B1narySolutions/seed3-carrier-board/README.md

# seed3-carrier

KiCad carrier board for the Daisy Seed, part of a capstone project: a portable touchscreen practice guitar amp.
The firmware is in [realtime-nam-seed3](https://github.com/B1narySolutions/realtime-nam-seed3).

## Layout

- `rev1/`: the board sent to fabrication on 2026-09-15 (also tagged `rev1`). Keep it unchanged while it is being tested. Manufacturing files are in `rev1/fabrication/`.
- `rev2/`: the next revision. The schematic starts as a copy of rev 1. There is no PCB file yet: rev 2 gets a full re-layout on a 4-layer stackup, starting from a new board in KiCad. Changes from rev 1 are listed in [`rev2/CHANGES.md`](rev2/CHANGES.md).
- `Seed3_Carrier.pretty/` and `seed3-carrier.kicad_sym`: footprint and symbol libraries shared by both revisions.
- `3dmodels/`: simplified STEP placeholder models for parts without a vendor 3D model (pots, jacks, Daisy Seed), generated by `make_placeholders.py`.
- `mechanical/`: STEP export of the rev 1 board assembly, for enclosure design.
- `TEST_PLAN.md`: post-assembly bring-up and acceptance tests for rev 1.
- [`studies/`](studies/): analysis of the board's behaviour (scripts, figures, write-ups). Current studies cover rev 1.

Open `rev1/seed3-carrier.kicad_pro` or `rev2/seed3-carrier.kicad_pro` in KiCad 10.

## Project documentation

Documentation lives alongside the work: hardware docs (board measurements, test plans, the rev 2 change list) in
this repository, firmware docs in [realtime-nam-seed3](https://github.com/B1narySolutions/realtime-nam-seed3).
