B1narySolutions/seed3-carrier-board/3dmodels/Neutrik_NRJ4HF_placeholder.step

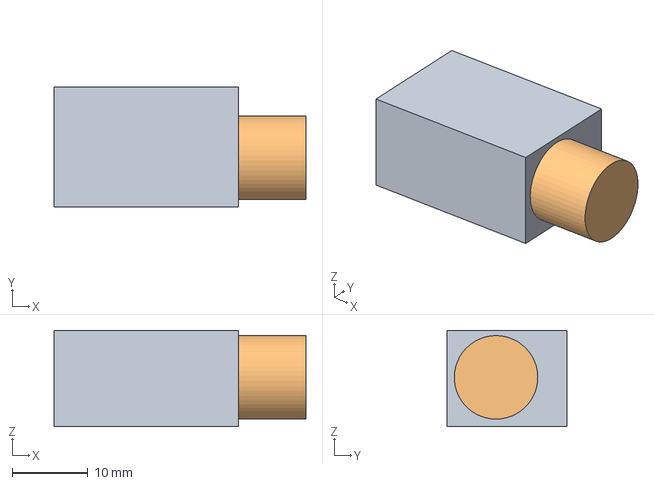
[picture p1: CAD file, 2026-10-18]
3dmodels/Neutrik_NRJ4HF_placeholder.step
33.2 x 15.8 x 12.7 mm
