B1narySolutions/seed3-carrier-board/mechanical/seed3-carrier.step

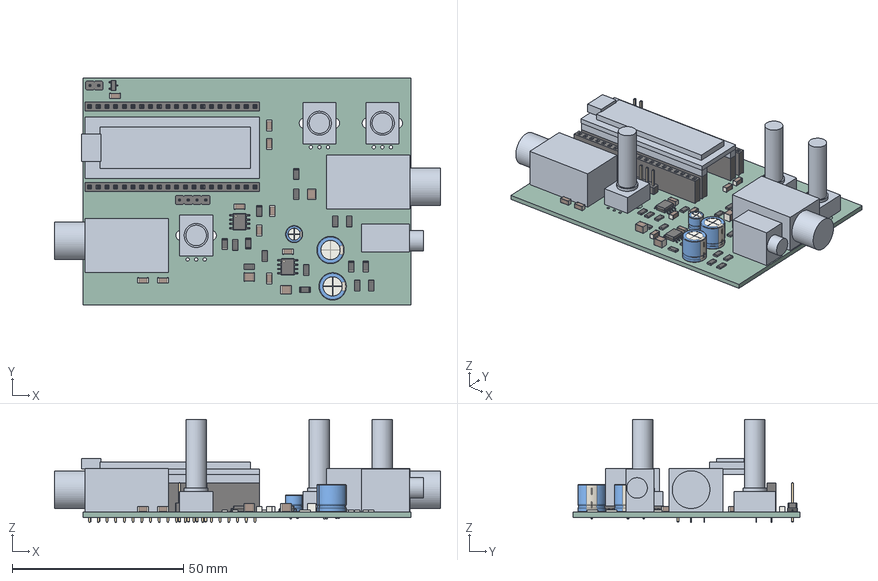
[picture p2: CAD file, 2026-10-18]
mechanical/seed3-carrier.step
112.7 x 66.2 x 30.1 mm
R_1206_3216Metric x 16
C_1206_3216Metric x 10
SOIC-8_3.9x4.9mm_P1.27mm x 2
PinSocket_1x20_P2.54mm_Vertical x 4
C_1210_3225Metric x 3
CP_Radial_D80mm_P350mm x 2
SOT-23
CP_Radial_D50mm_P200mm
PinHeader_1x02_P254mm_Vertical
PinHeader_1x04_P254mm_Vertical
seed3-carrier_PCB
