B1narySolutions/seed3-carrier-board/3dmodels/Bourns_PTV09A-4020F_placeholder.step

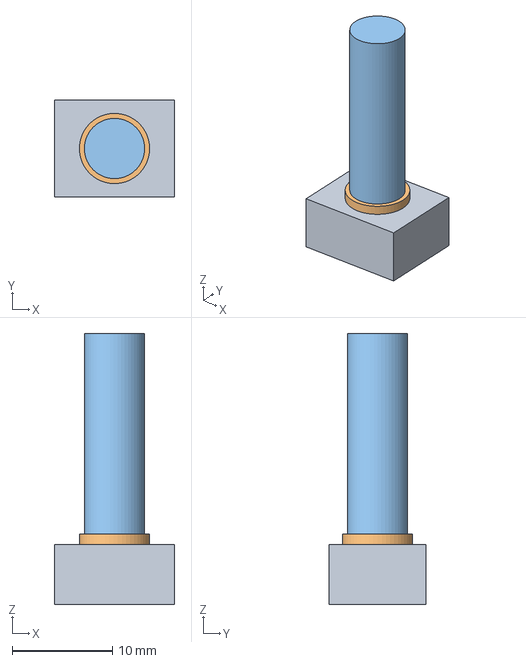
[picture p3: CAD file, 2026-10-18]
3dmodels/Bourns_PTV09A-4020F_placeholder.step
12.0 x 9.70 x 27.0 mm
