B1narySolutions/seed3-carrier-board/3dmodels/Electrosmith_Daisy_Seed_placeholder.step

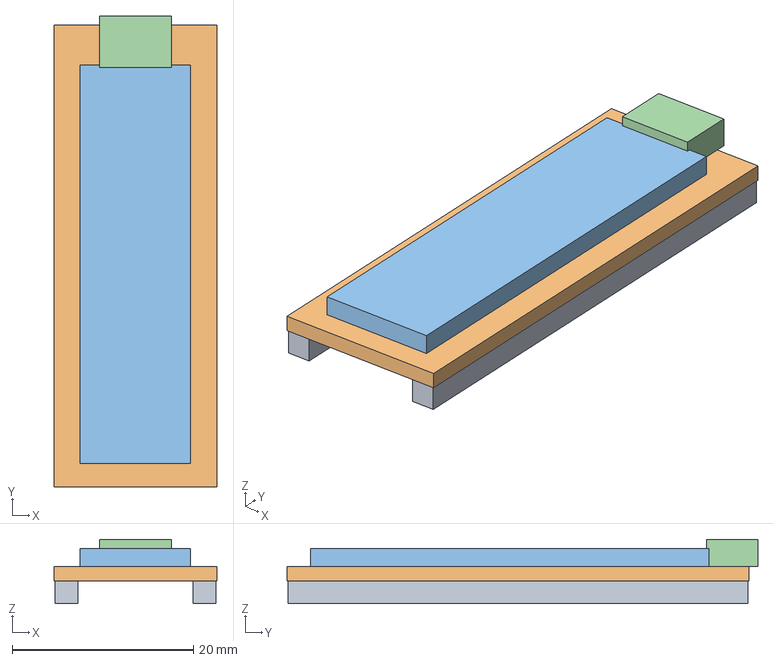
[picture p4: CAD file, 2026-10-18]
3dmodels/Electrosmith_Daisy_Seed_placeholder.step
18.0 x 52.0 x 7.10 mm
