B1narySolutions/seed3-carrier-board/3dmodels/SameSky_SJ1-3535NG_placeholder.step

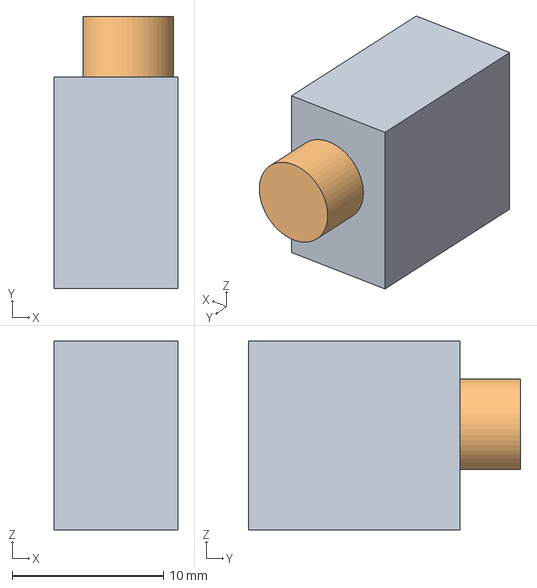
[picture p5: CAD file, 2026-10-18]
3dmodels/SameSky_SJ1-3535NG_placeholder.step
8.20 x 18.0 x 12.5 mm
