B1narySolutions/seed3-carrier-board/fabrication/README.txt

Use 2026-09-15-e7ddc60/seed3-carrier-e7ddc60-JLCPCB.zip for manufacturing.
Superseded manufacturing packages have been removed; they remain available in Git history. See the current package README for mounting and verification notes.
The BOM is seed3-carrier-BOM.csv; no placement files are included.
The BOM now contains selected manufacturer part numbers, small-quantity DigiKey ordering numbers, product links, and quantities per board. Purchase Quantity excludes the already-owned Daisy module and bare PCB test pads.
Purchasing fields were added to the CSV on 2026-09-15; they are not all stored in the schematic. Preserve these fields when regenerating the BOM from KiCad.
The BOM was regenerated from seed3-carrier.kicad_sch with kicad-cli 10.0.5 on 2026-09-17; references, values, footprints and quantities matched the existing CSV exactly, so no part selections changed.
DigiKey stock, part status and qty-1 unit price were rechecked on 2026-09-17 and recorded in the Part Status, DigiKey Stock, Unit Price (qty 1) and Stock Checked columns. All 28 ordering numbers were in stock. C9 (GMK316BJ106KL-T) and C12/C13 (GRM32ER71H475KA88L) remain Not For New Designs with ample stock. Availability can be cached; recheck at checkout.
