B1narySolutions/seed3-carrier-board/rev1/fabrication/2026-09-15-e7ddc60/README.txt

Current manufacturing package from committed design e7ddc60.
Includes resized board, routing corrections, and latest R3/R4 placement.
Board outline: 95.758 x 66.167 mm; 2 copper layers; configured thickness 1.6 mm.
Exported from a zone-refilled copy of the committed PCB, with absolute origins.
DRC: zero errors, zero unconnected items, zero schematic parity issues.
Eight existing connector/module silkscreen-edge warnings remain.
ZIP: seven Gerber layers, PTH and NPTH Excellon drills, Gerber job metadata.
Potentiometer mounting tabs use six 3.0 mm plated holes; solder these tabs.
BOM remains ../seed3-carrier-BOM.csv; no BOM or placement file inside ZIP.
This package supersedes all earlier manufacturing packages in fabrication/.
