B1narySolutions/seed3-carrier-board/rev1/seed3-carrier.kicad_pcb

## KiCad design rev1/seed3-carrier.kicad_pcb (2026-10-18, an earlier design)

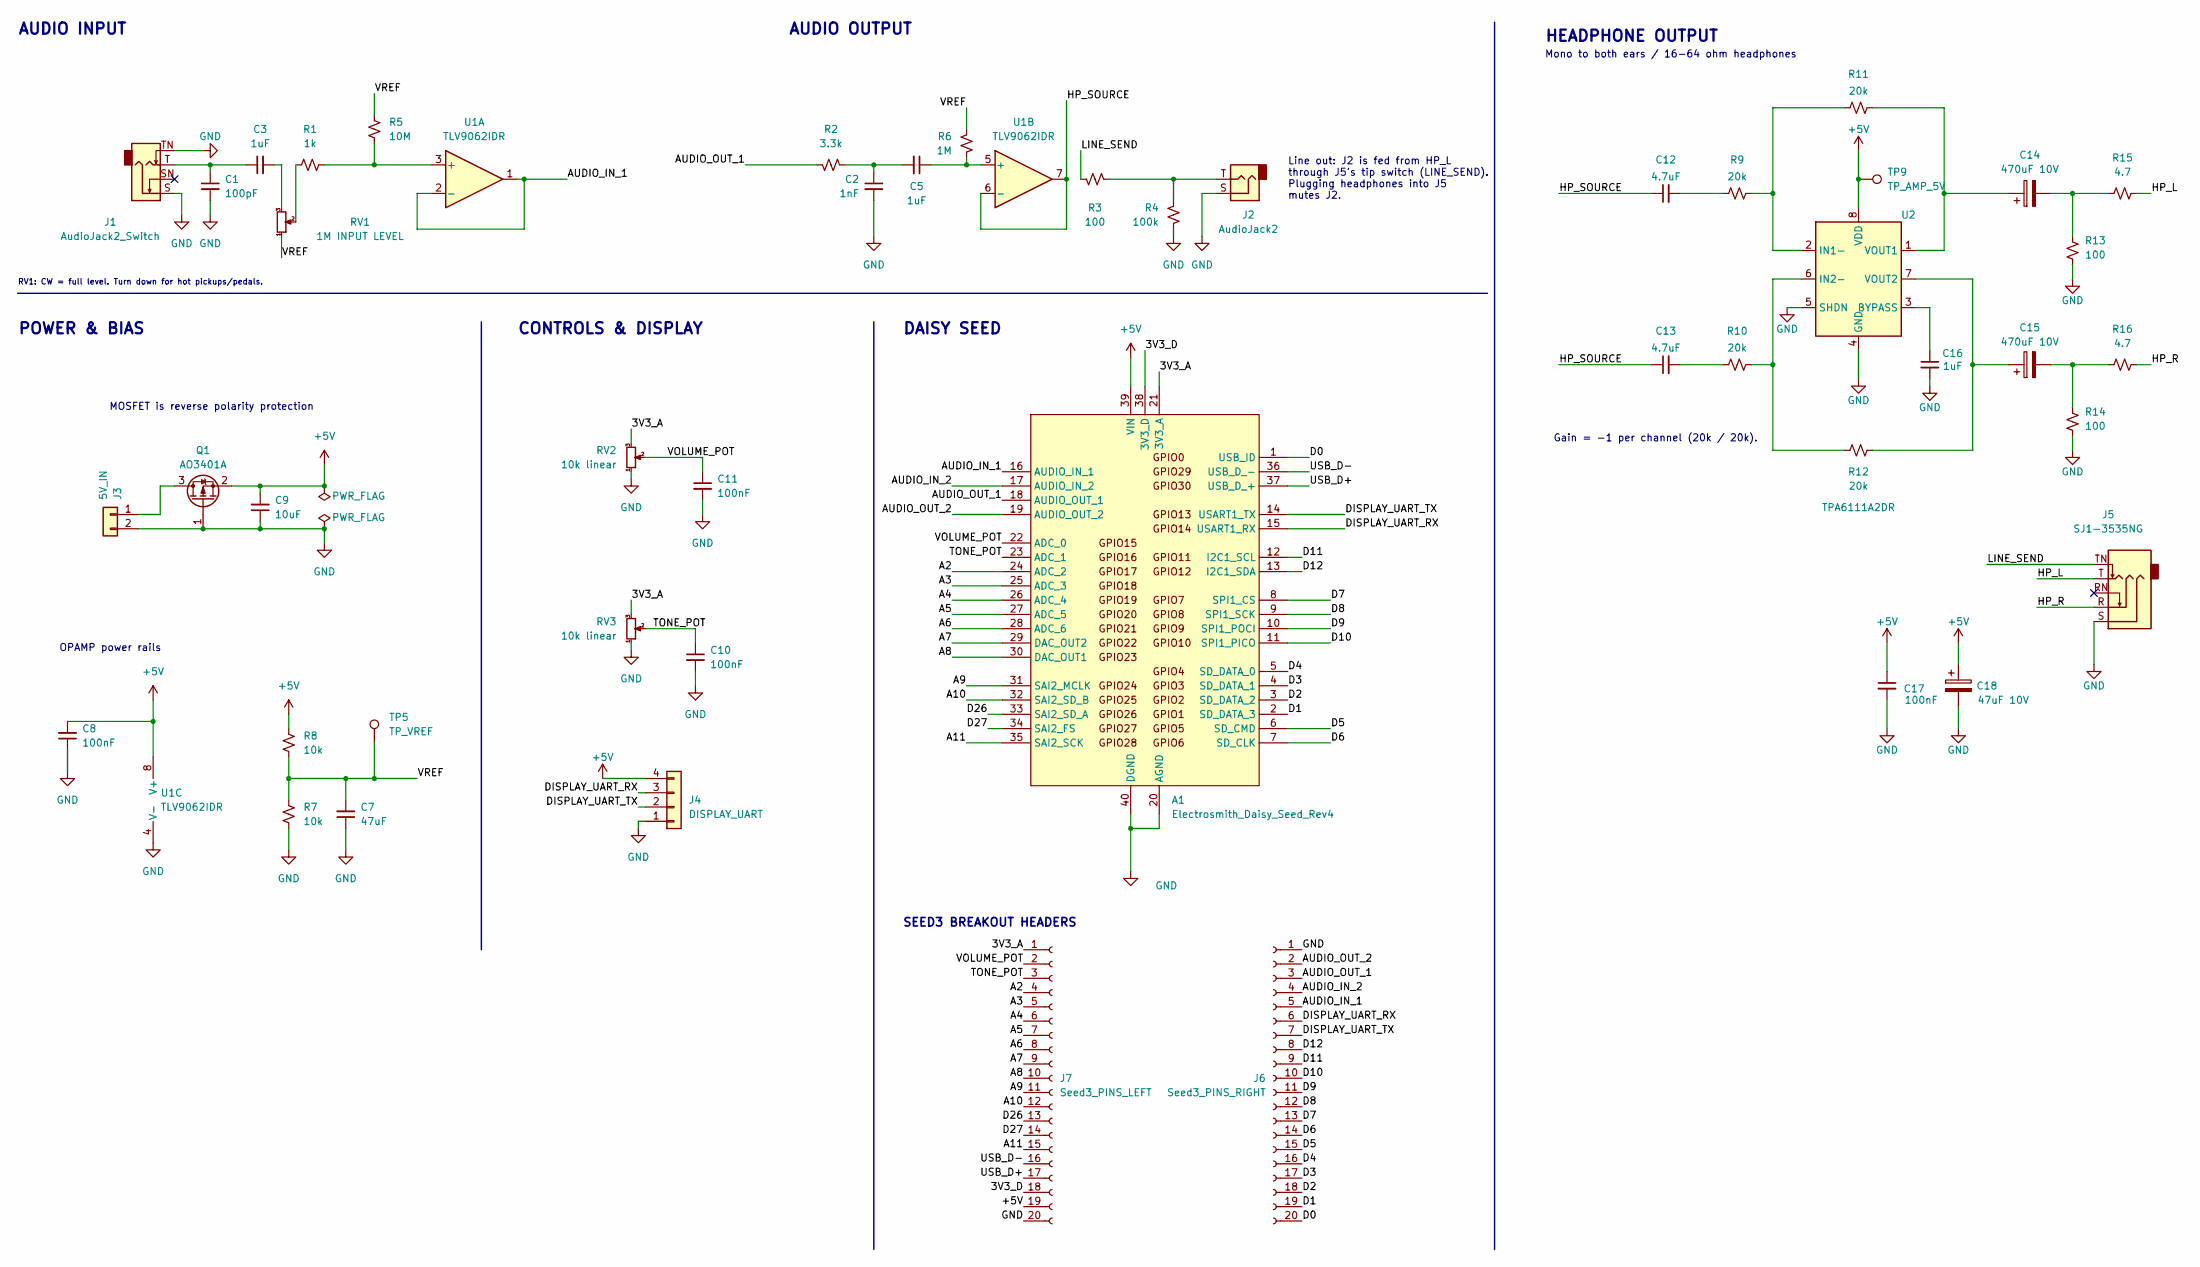
[picture p6: schematic seed3-carrier.kicad_sch, Seed3 Carrier]

Parts:
A1: Electrosmith_Daisy_Seed_Rev4; Electrosmith_Daisy_Seed
C1: 100pF; C_1206_3216Metric_Pad1.33x1.80mm_HandSolder
C2: 1nF; C_1206_3216Metric_Pad1.33x1.80mm_HandSolder
C3, C5, C16: 1uF; C_1206_3216Metric_Pad1.33x1.80mm_HandSolder
C7: 47uF; C_1210_3225Metric_Pad1.33x2.70mm_HandSolder
C8, C10, C11, C17: 100nF; C_1206_3216Metric_Pad1.33x1.80mm_HandSolder
C9: 10uF; C_1206_3216Metric_Pad1.33x1.80mm_HandSolder
C12, C13: 4.7uF; C_1210_3225Metric_Pad1.33x2.70mm_HandSolder; MPN GRM32ER71H475KA88L
C14, C15: 470uF 10V; CP_Radial_D8.0mm_P3.50mm
C18: 47uF 10V; CP_Radial_D5.0mm_P2.00mm
J1: AudioJack2_Switch; Jack_6.35mm_Neutrik_NRJ4HF_Horizontal
J2: AudioJack2; Jack_6.35mm_Neutrik_NRJ4HF_Horizontal
J3: 5V_IN; PinHeader_1x02_P2.54mm_Vertical
J4: DISPLAY_UART; PinHeader_1x04_P2.54mm_Vertical
J5: SJ1-3535NG; Jack_3.5mm_CUI_SJ1-3535NG_Horizontal
J6: Seed3_PINS_RIGHT; PinSocket_1x20_P2.54mm_Vertical
J7: Seed3_PINS_LEFT; PinSocket_1x20_P2.54mm_Vertical
Q1: AO3401A; SOT-23
R1: 1k; R_1206_3216Metric_Pad1.30x1.75mm_HandSolder
R2: 3.3k; R_1206_3216Metric_Pad1.30x1.75mm_HandSolder
R3, R13, R14: 100; R_1206_3216Metric_Pad1.30x1.75mm_HandSolder
R4: 100k; R_1206_3216Metric_Pad1.30x1.75mm_HandSolder
R5: 10M; R_1206_3216Metric_Pad1.30x1.75mm_HandSolder
R6: 1M; R_1206_3216Metric_Pad1.30x1.75mm_HandSolder
R7, R8: 10k; R_1206_3216Metric_Pad1.30x1.75mm_HandSolder
R9, R10, R11, R12: 20k; R_1206_3216Metric_Pad1.30x1.75mm_HandSolder
R15, R16: 4.7; R_1206_3216Metric_Pad1.30x1.75mm_HandSolder
RV1: 1M INPUT LEVEL; Potentiometer_Bourns_PTV09A-4_Single_Vertical_3mmMount; MPN PTV09A-4020F-B105
RV2, RV3: 10k linear; Potentiometer_Bourns_PTV09A-4_Single_Vertical_3mmMount; MPN PTV09A-4020F-B103
TP5: TP_VREF; TestPoint_Pad_D2.0mm
TP9: TP_AMP_5V; TestPoint_Pad_D2.0mm
U1: TLV9062IDR; SOIC-8_3.9x4.9mm_P1.27mm
U2: TPA6111A2DR; SOIC-8_3.9x4.9mm_P1.27mm

Connections:
+5V: A1.39 (VIN), C8.2, C9.2, C17.1, C18.1, J4.4, J7.19, Q1.2 (S), R8.1, TP9.1 (1_1), U1.8 (V+), U2.8 (VDD)
/3V3_A: A1.21 (3V3_A), J7.1, RV2.3, RV3.3
/3V3_D: A1.38 (3V3_D), J7.18
/A2: A1.24 (ADC_2), J7.4
/A3: A1.25 (ADC_3), J7.5
/A4: A1.26 (ADC_4), J7.6
/A5: A1.27 (ADC_5), J7.7
/A6: A1.28 (ADC_6), J7.8
/A7: A1.29 (DAC_OUT2), J7.9
/A8: A1.30 (DAC_OUT1), J7.10
/A9: A1.31 (SAI2_MCLK), J7.11
/A10: A1.32 (SAI2_SD_B), J7.12
/A11: A1.35 (SAI2_SCK), J7.15
/AUDIO_IN_1: A1.16 (AUDIO_IN_1), J6.5, U1.1, U1.2 (-)
/AUDIO_IN_2: A1.17 (AUDIO_IN_2), J6.4
/AUDIO_OUT_1: A1.18 (AUDIO_OUT_1), J6.3, R2.2
/AUDIO_OUT_2: A1.19 (AUDIO_OUT_2), J6.2
/D0: A1.1 (USB_ID), J6.20
/D1: A1.2 (SD_DATA_3), J6.19
/D2: A1.3 (SD_DATA_2), J6.18
/D3: A1.4 (SD_DATA_1), J6.17
/D4: A1.5 (SD_DATA_0), J6.16
/D5: A1.6 (SD_CMD), J6.15
/D6: A1.7 (SD_CLK), J6.14
/D7: A1.8 (SPI1_CS), J6.13
/D8: A1.9 (SPI1_SCK), J6.12
/D9: A1.10 (SPI1_POCI), J6.11
/D10: A1.11 (SPI1_PICO), J6.10
/D11: A1.12 (I2C1_SCL), J6.9
/D12: A1.13 (I2C1_SDA), J6.8
/D26: A1.33 (SAI2_SD_A), J7.13
/D27: A1.34 (SAI2_FS), J7.14
/DISPLAY_UART_RX: A1.15 (USART1_RX), J4.3, J6.6
/DISPLAY_UART_TX: A1.14 (USART1_TX), J4.2, J6.7
/HP_L: J5.T, R15.2
/HP_R: J5.R, R16.2
/HP_SOURCE: C12.1, C13.1, U1.6 (-), U1.7
/LINE_SEND: J5.TN, R3.2
/TONE_POT: A1.23 (ADC_1), C10.1, J7.3, RV3.2
/USB_D+: A1.37 (USB_D_+), J7.17
/USB_D-: A1.36 (USB_D_-), J7.16
/VOLUME_POT: A1.22 (ADC_0), C11.1, J7.2, RV2.2
/VREF: C7.2, R5.1, R6.1, R7.1, R8.2, RV1.1, TP5.1 (1_1)
GND: A1.20 (AGND), A1.40 (DGND), C1.2, C2.2, C7.1, C8.1, C9.1, C10.2, C11.2, C16.2, C17.2, C18.2, J1.S, J1.TN, J2.S, J3.2, J4.1, J5.S, J6.1, J7.20, Q1.1 (G), R4.1, R7.2, R13.2, R14.2, RV2.1, RV3.1, U1.4 (V-), U2.4 (GND), U2.5 (SHDN)
unnamed: C1.1, C3.1, J1.T
unnamed: C2.1, C5.2, R2.1
unnamed: C3.2, RV1.3
unnamed: C12.2, R9.1
unnamed: C13.2, R10.1
unnamed: C14.2, R13.1, R15.1
unnamed: C15.2, R14.1, R16.1
unnamed: J2.T, R3.1, R4.2
unnamed: J3.1, Q1.3 (D)
unnamed: R1.1, RV1.2
unnamed: R1.2, R5.2, U1.3 (+)
unnamed: C5.1, R6.2, U1.5 (+)
unnamed: C16.1, U2.3 (BYPASS)
unnamed: R9.2, R11.1, U2.2 (IN1-)
unnamed: R10.2, R12.1, U2.6 (IN2-)
unnamed: C14.1, R11.2, U2.1 (VOUT1)
unnamed: C15.1, R12.2, U2.7 (VOUT2)

Notes on the sheet:
RV1: CW = full level. Turn down for hot pickups/pedals.
HEADPHONE OUTPUT
AUDIO OUTPUT
DAISY SEED
SEED3 BREAKOUT HEADERS
OPAMP power rails
AUDIO INPUT
MOSFET is reverse polarity protection
Mono to both ears / 16-64 ohm headphones
Gain = -1 per channel (20k / 20k).
CONTROLS & DISPLAY
POWER & BIAS
Line out: J2 is fed from HP_L through J5's tip switch (LINE_SEND). Plugging headphones into J5 mutes J2.

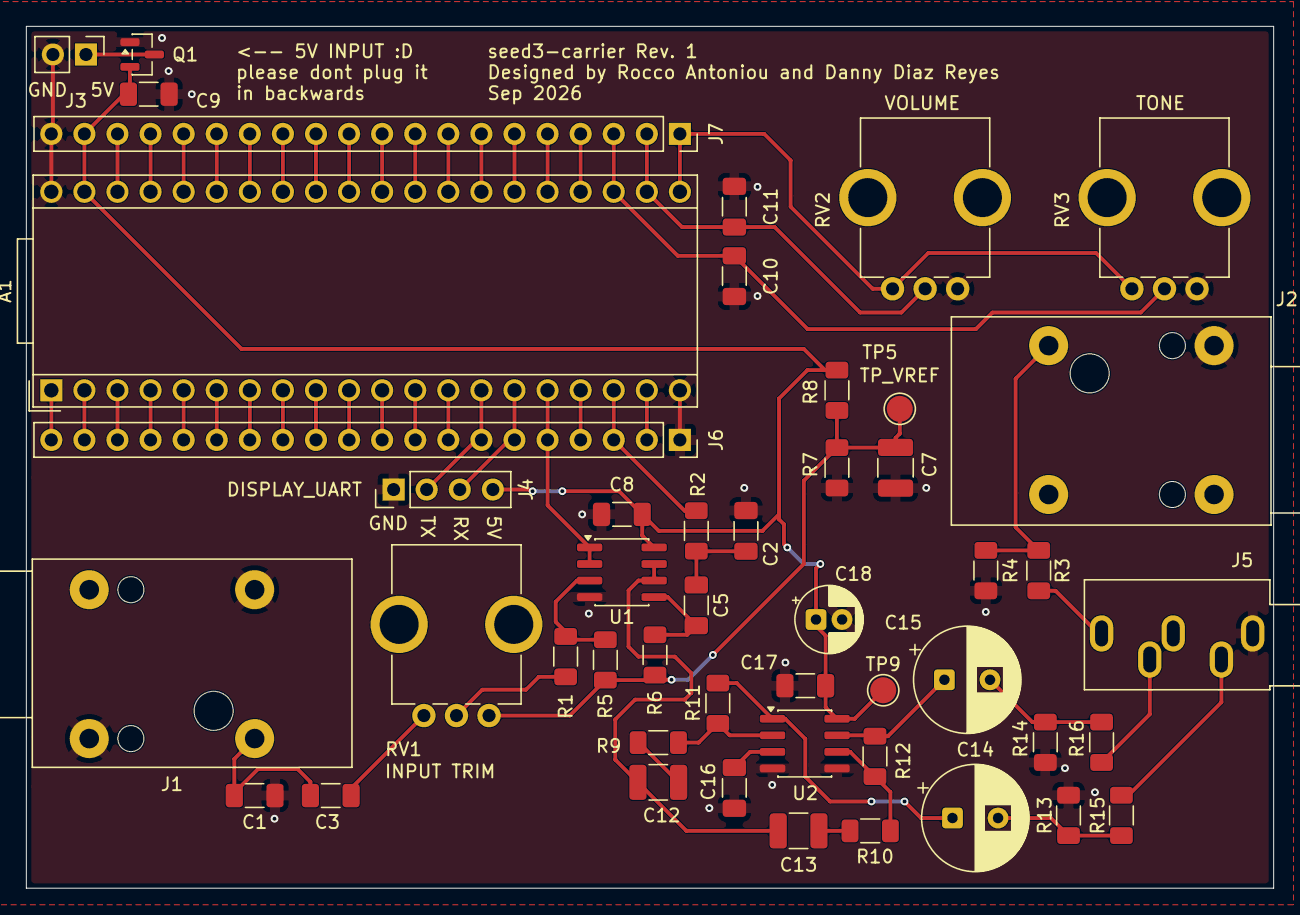
[picture p7: board seed3-carrier.kicad_pcb from above]

Board: 2 copper layers, 95.8 x 66.2 mm, 48 parts (0 on the bottom side), 61 nets.
