B1narySolutions/seed3-carrier-board/(commit log)

2026-09-17 Verify BOM against DigiKey and add ordering lists
    Regenerate the BOM from seed3-carrier.kicad_sch with kicad-cli 10.0.5.
    References, values, footprints and quantities matched the existing CSV
    exactly, so no part selections changed.
    Verify all 28 DigiKey ordering numbers against the live product pages:
    electrical value, package against the KiCad footprint, and stock. All
    28 match and all are in stock. Record part status, stock, qty-1 unit
    price and the check date in new BOM columns.
    Connector contact counts were cross-checked against the netlist: J1
    uses all four contacts of the mono NRJ4HF, J5 all five of the
    SJ1-3535NG, and every other part's pin count fits its package.
    Add DigiKey order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
    [digikey-order-1board.csv, seed3-carrier-BOM.csv]
2026-09-29 Tidy schematic and clear ERC warnings
    Remove redundant VIN/DGND/AGND labels at A1 and rename the breakout
    header labels to +5V/GND. Add a heading for the Seed3 breakout headers
    and extend the Daisy Seed section to enclose them. Move J1's text clear
    of the adjacent GND symbol.
    [seed3-carrier.kicad_sch]
2026-09-29 Refine schematic text, power symbols and title block
    Replace the GND/+5V labels on J1 and J4 with power symbols. Rewrite the
    J2/J5 line-out note and move it beside J2. Put reference above value on
    C5, J2, J4, RV2 and RV3, and align R13 with R14. Move the op-amp power
    rail group up to even out Power & Bias spacing. Set title block date to
    2026-09-28 and rev to 1.0.
    [seed3-carrier.kicad_sch]
2026-09-29 Drop duplicate order lists and add prototyping order
    The one-board DigiKey order was stored three times; keep only the CSV,
    which DigiKey's BOM upload accepts directly. Add the separate order of
    breadboard prototyping parts (ferrites, amp and buck modules, LDOs).
    [digikey-order-prototyping.csv]
2026-10-13 Move rev 1 KiCad project into rev1/
    Libraries stay at the repo root so rev 1 and rev 2 share them; the
    project lib tables now point one level up.
    Claude-Session: https://claude.ai/code/session_015nPf6LbpaFraCZvzYUaZDM
2026-10-13 Add rev 2 KiCad project
    The schematic is a copy of rev 1 with the title block set to revision
    2.0. The PCB keeps rev 1's layer stack and design rules but has no
    parts, tracks or outline yet. The README describes the new layout.
    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
2026-10-18 Add placeholder 3D models and STEP export for enclosure design
    Simplified STEP models for the NRJ4HF and SJ1-3535NG jacks, PTV09A pots
    and Daisy Seed, sized from manufacturer drawings so jack and shaft
    centrelines are accurate. Footprints now reference them, and
    mechanical/seed3-carrier.step is the full-board export for Onshape.
2026-10-18 Add studies folder with signal-path phase and delay study
    Models the carrier's input and output analog stages from BOM values and
    plots magnitude, phase and group delay with the Daisy treated as ideal.
2026-10-18 Seat Daisy on female sockets and add them to the BOM
    The Daisy is meant to plug in so it can be swapped, so A1 now carries two
    1x20 socket models and the Daisy placeholder sits 11 mm up on them. Adds
    the two PPPC201LFBN-RC sockets to the BOM as a BOM-only row and bumps the
    DigiKey order to four, and re-exports the board STEP.
2026-10-18 Add board outline dimensions to rev 1 PCB
    Two orthogonal dimensions measuring the board at 95.758 x 66.294 mm.
2026-10-18 Add rev 1 post-assembly test plan
    Staged bring-up and acceptance tests for a hand-assembled rev 1 board:
    inspection, unpowered checks, power-up with and without the Daisy,
    analog path checks via the J6 breakout, firmware functional tests and soak.
2026-10-18 Remove board dimensions from the F.Cu layer in rev 1
    They would have been etched as copper text in a Gerber export.
2026-10-18 Remove empty rev 2 PCB file ahead of a 4-layer re-layout
    The stub was an empty 2-layer board. Rev 2 will start from a new board
    in KiCad with a 4-layer stackup.
2026-10-18 Replace rev 2 pots with a volume encoder and add a watchdog output mute
    - Remove RV1-RV3, C10, C11. R17 (1M to VREF) keeps the guitar input load;
    input trim and tone move to firmware.
    - Add SW1 rotary encoder with push switch and RC conditioning on ENC_A/B/SW
    (Daisy pins 22/23/24).
    - Add U3 (SN74LVC1G123) + Q2: U2 SHUTDOWN is pulled to +5V (muted) unless the
    firmware toggles AUDIO_ALIVE (pin 33) every audio callback; ~10 ms timeout.
    - Add rev2/CHANGES.md listing these changes, firmware impact and open items.
2026-10-18 Feed the speaker from AUDIO_OUT_2 and detect headphones in firmware
    - Drop the J5 tip-switch line out; TN/RN are now no-connects.
    - Add AUDIO_OUT_2 -> RC filter -> U1C buffer -> C26 -> LINE_SEND -> J2.
    - Swap U1 to a TLV9064 quad (SOIC-14); U1D parked as a VREF follower for
    the future AUX input buffer.
    - Add HP_DETECT on Daisy pin 34 (was D27) with pull-up, series R, filter
    cap and TP11; J5 still needs a jack with an isolated detect switch.
    - Update rev2/CHANGES.md.
2026-10-18 Use SJ3-35063AG for J5 with an isolated headphone-detect switch
    - Add SJ3-35063AG symbol (project library) and footprint (Seed3_Carrier),
    drawn from the Same Sky SJ3-3506X recommended PCB layout.
    - Swap J5 in rev 2: tip/ring/sleeve unchanged; pin 5 to GND, pin 6 (N-O,
    closes on insertion) to HP_DETECT_SW, so HP_DETECT is low with
    headphones in.
    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
2026-10-24 Replace J3 with an 8-pin JST-XH power board connector
    - J3 is now a JST-XH B8B-XH-A carrying 5V (pins 1-2), GND (3-4),
    BATT_SENSE, PWR_BTN, PWR_HOLD and SPK_MUTE (5-8). Q1 stays as
    reverse-polarity protection on the new 5V_IN net.
    - Daisy pins 25-28 (A3-A6) become BATT_SENSE, PWR_BTN, PWR_HOLD and
    SPK_EN, also renamed on the J7 breakout. Add R32-R36, C28, C29 for
    filtering, pull-up and pull-down.
    - Add Q3/Q4 in series so SPK_MUTE only unmutes the speaker amp when
    the watchdog (U3 Q, now named WD_OK) and SPK_EN are both high.
    AMP_SHUTDOWN now mutes only the headphone amp.
    - Feed the display through FB1 and C30 (J4 pin 4 is now DISPLAY_5V).
    - Update rev2/CHANGES.md with the pin map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
2026-10-24 Add J8 internal line out to the speaker amp
    - Add J8, a 2-pin JST-XH (B2B-XH-A): pin 1 on J2's tip after R3,
    now named LINE_OUT, and pin 2 on GND. It feeds the speaker amp on
    the power board or a class D module while prototyping.
    - Keep J2 as an external line out on the same net.
    - Document J8, cabling and speaker wiring in rev2/CHANGES.md.
2026-10-24 Add the AUX input on J9 through U1D to AUDIO_IN_2
    - Add J9, a second SJ3-35063AG 3.5 mm TRS jack. Its detect switch
    is not connected.
    - Sum tip and ring to mono with R40/R41 (10k), hold the node with
    R38 (47k) and C31 (1nF), AC-couple with C32 (1uF) biased to VREF
    by R39 (100k), then R42 (1k) into the U1D follower driving
    AUDIO_IN_2.
    - Remove U1D's VREF-follower parking and move it next to the AUX
    parts. Rename the section to "Speaker / line send, AUX input".
    - Document the path, firmware mixing and the level check in
    rev2/CHANGES.md.
2026-10-24 Apply rev 2 schematic design review fixes
    Technical:
    - R32 1k -> 10k so the power board's battery divider cannot
    back-power an unpowered Daisy through BATT_SENSE.
    - R13/R14 100R -> 1k: now only bleed resistors for C14/C15 since
    the rev 1 tip-switch line out is gone.
    - Add R43/R44 (1k) in series with the display UART. J4 now carries
    UART_TX_CONN/UART_RX_CONN.
    Style:
    - Add voltage ratings to C7, C9, C26 and C30. Rename TP9 to TP_5V.
    - Rename "Audio output" to "Headphone buffer" and update the Q1,
    op-amp rail and watchdog notes. Update the title block date.
    - Move C9's labels clear of the PWR_FLAG symbols.
    - Record the fixes and the BATT_SENSE power board requirement in
    rev2/CHANGES.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
2026-10-24 Replace the TPA6111A2 headphone amp with a TPA6132A2
    - U2 is now a TPA6132A2RTE DirectPath amp (WQFN-16). Its outputs sit
    at 0 V and drive J5 directly.
    - Remove C14/C15 (470uF output caps), R9-R16, C16, Q2 and R27.
    - Add C33 (VDD), C34 (HPVDD), C35 (flying) and C36 (HPVSS) per the
    datasheet. Inputs are single ended through C12/C13, and gain is
    0 dB (G0 high, G1 low).
    - Drive U2's active-high EN straight from WD_OK, replacing
    AMP_SHUTDOWN. Move TP10 onto WD_OK.
    - Add a TPA6132A2RTE symbol with pins arranged for this circuit to
    seed3-carrier.kicad_sym.
    - Update rev2/CHANGES.md: the watchdog, the power connector and
    firmware notes, open items, and a new section for the swap.
    Co-Aut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
